atharvajshinde/Project-A.R.C./web/assets/branding/01_aerospace_frame.png

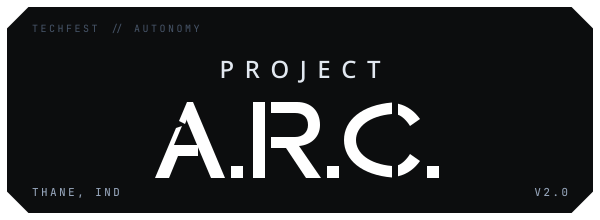
web/assets/branding/01_aerospace_frame.png
