atharvajshinde/Project-A.R.C./web/assets/branding/03_circular_seal.png

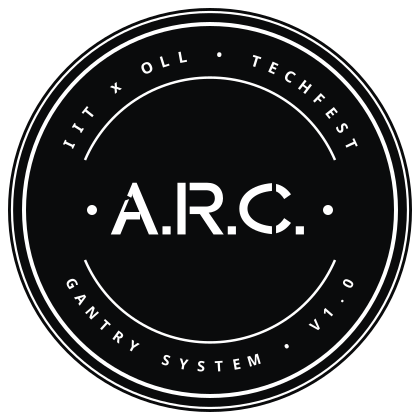
web/assets/branding/03_circular_seal.png
