atharvajshinde/Project-A.R.C./web/assets/branding/03_circular_seal_minimal.png

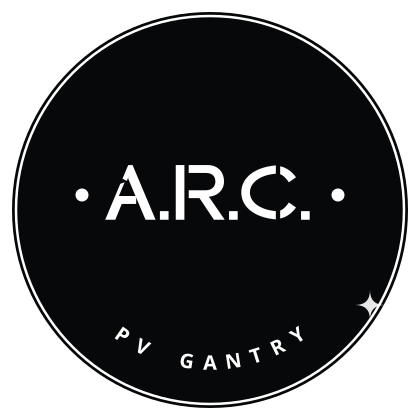
web/assets/branding/03_circular_seal_minimal.png
