atharvajshinde/Project-A.R.C./web/assets/branding/arc_sticker_sheet.png

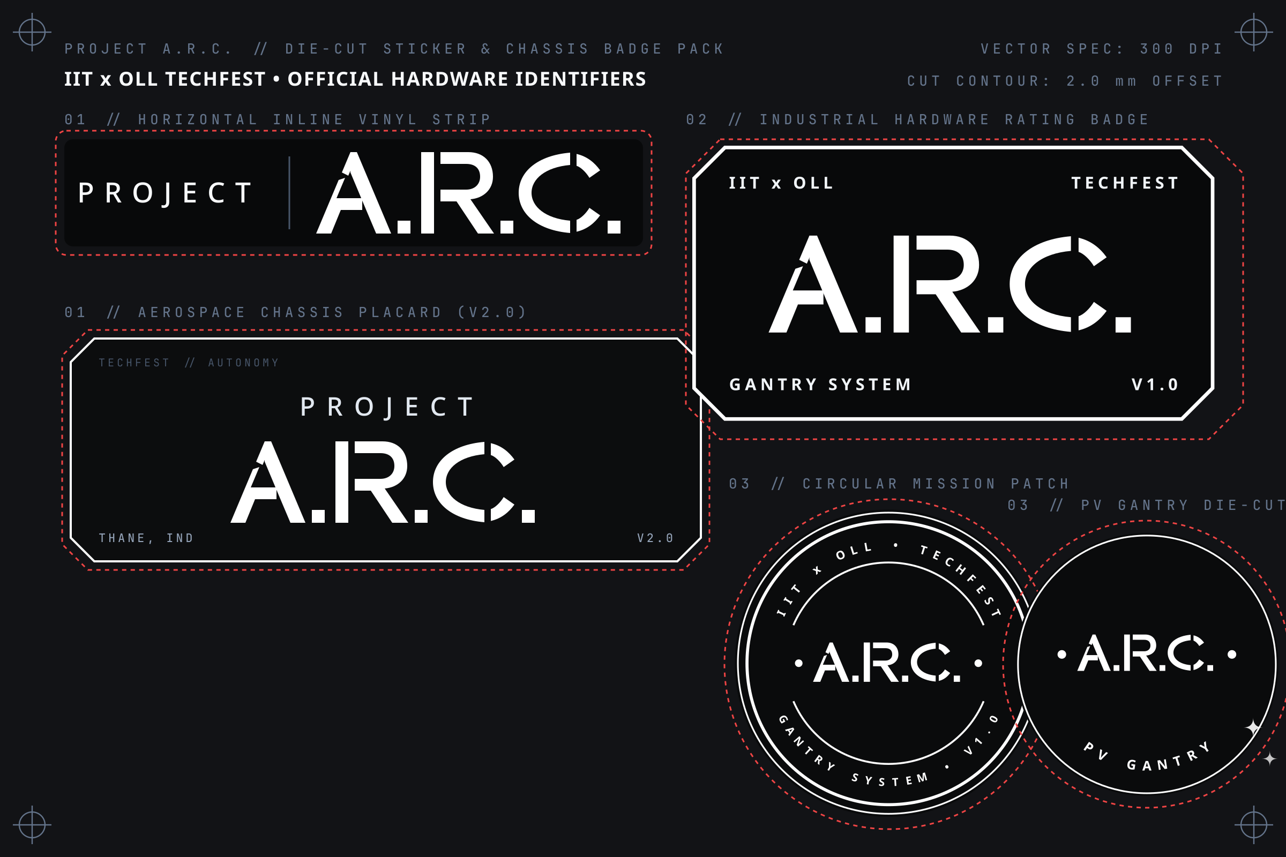
web/assets/branding/arc_sticker_sheet.png
