atharvajshinde/Project-A.R.C./cad/exports/step/arc_full_assembly.step

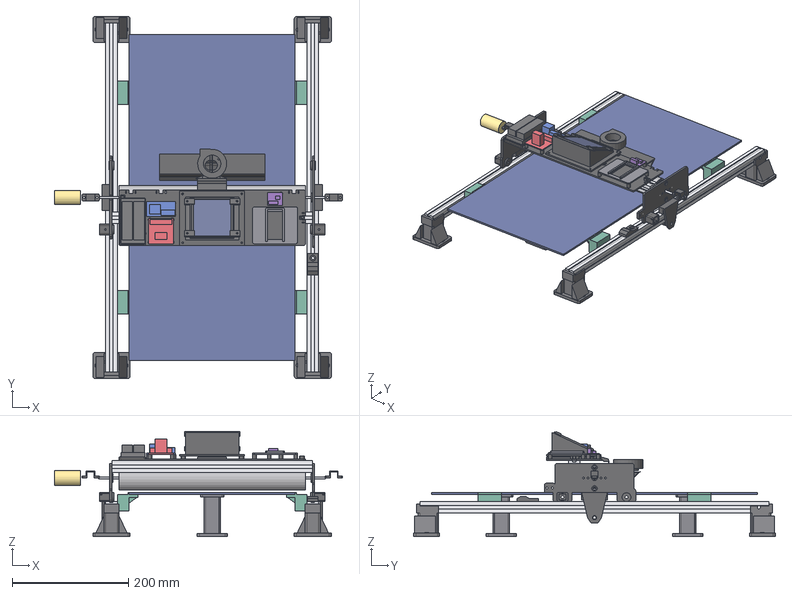
[picture p9: CAD file, 2026-10-25]
cad/exports/step/arc_full_assembly.step
495.0 x 622.0 x 180.4 mm
roller_conduit
roller_axle
roller_plug_left
roller_plug_right
endplate_left
endplate_right
motor_clamp_left
motor_clamp_right
cowl_right
chassis_tray
blower_cowl_mount
solar_wedge
pv_clip_3 x 4
limit_dog
cots_crossbeam_2020
cots_guide_rail_left
cots_vwheel_left_0
cots_vwheel_left_1
cots_vwheel_left_2
cots_guide_rail_right
cots_vwheel_right_0
cots_vwheel_right_1
cots_vwheel_right_2
cots_blower_5015
cots_motor_25ga370
cots_solar_panel
cots_pv_mini_panel
esp32_adapter_sled
cots_motor_driver_l298n
cots_relay_module
cots_ina219
cots_battery_2x18650
testbed_rail_riser_lf
testbed_rail_riser_lr
testbed_rail_riser_rf
testbed_rail_riser_rr
testbed_panel_bracket_lf
testbed_panel_bracket_lr
testbed_panel_bracket_rf
testbed_panel_bracket_rr
testbed_pedestal_front
testbed_pedestal_rear
