atharvajshinde/Project-A.R.C./cad/exports/step/arc_full_assembly_full.step

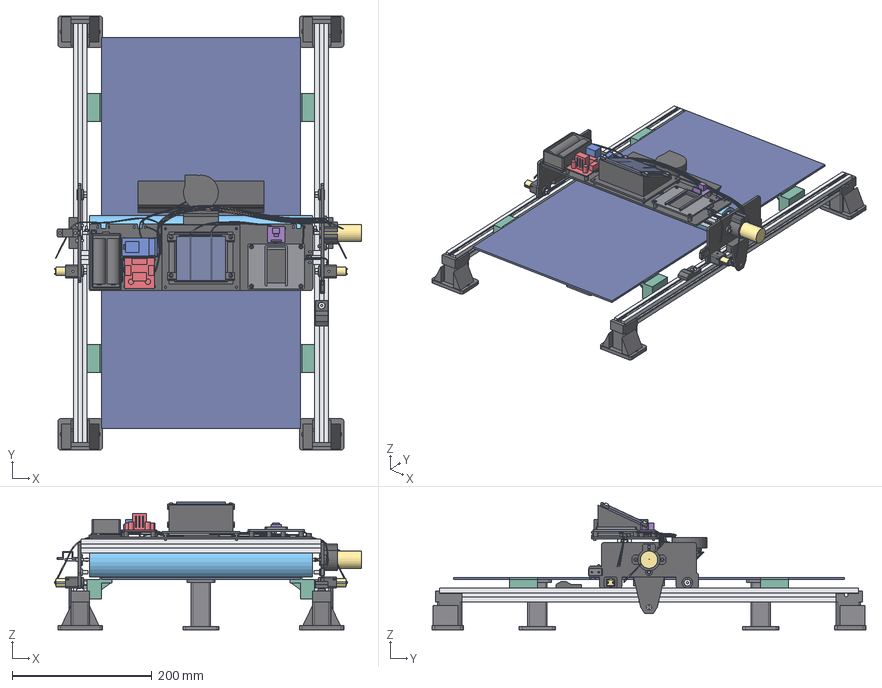
[picture p10: CAD file, 2026-10-25]
cad/exports/step/arc_full_assembly_full.step
440.2 x 622.0 x 183.0 mm
roller_conduit
roller_sleeve
roller_axle
roller_plug_left
roller_plug_right
endplate_left
endplate_right
motor_clamp_left
motor_clamp_right
cowl_right
chassis_tray
blower_cowl_mount
solar_wedge
pv_clip_3 x 4
limit_dog
cots_crossbeam_2020
cots_guide_rail_right x 2
cots_vwheel_right_2 x 6
cots_blower_5015
cots_motor_25ga370
cots_motor_n20_right x 2
coupler_n20_vwheel_left
coupler_n20_vwheel_right
cots_solar_panel
cots_pv_mini_panel
esp32_adapter_sled
cots_motor_driver_l298n
cots_relay_module
cots_ina219
cots_battery_2x18650
cots_limit_switch
hw_bearing_684zz_r x 2
hw_nut_m3_roller_plug_r x 2
hw_grub_m3_roller_plug_r x 2
hw_screw_m5_dog x 7
hw_screw_m3_wedge_base_3 x 6
hw_screw_m3_motor_clamp_r_1 x 2
hw_screw_m5_vwheel_right_2 x 6
hw_dowel_pin_cowl_1 x 2
hw_screw_m3_blower_3 x 4
hw_tnut_m5_dog x 3
hw_screw_m3_ina219_1 x 14
hw_screw_m3_pv_clip_3 x 4
wire_net_vbat_pos
wire_net_vbat_neg
wire_net_5v_sys
wire_net_gnd_sys
wire_net_blower_pwr
wire_net_blower_gnd
wire_net_motor_l_a
wire_net_motor_l_b
wire_net_motor_r_a
wire_net_motor_r_b
wire_net_motor_roller_pos
wire_net_motor_roller_neg
wire_net_limit_sig
wire_net_limit_gnd
wire_net_pv_pos
wire_net_pv_neg
wire_net_i2c_sda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
