atharvajshinde/Project-A.R.C./cad/exports/step/n20_motor_clamp.step

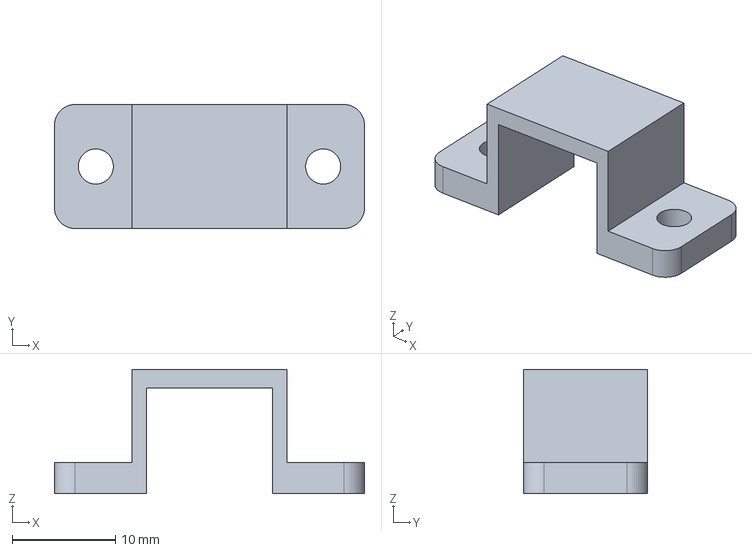
[picture p11: CAD file, 2026-10-25]
cad/exports/step/n20_motor_clamp.step
30.0 x 12.0 x 12.0 mm
