atharvajshinde/Project-A.R.C./cad/exports/stl/b123d_endplate_left.stl

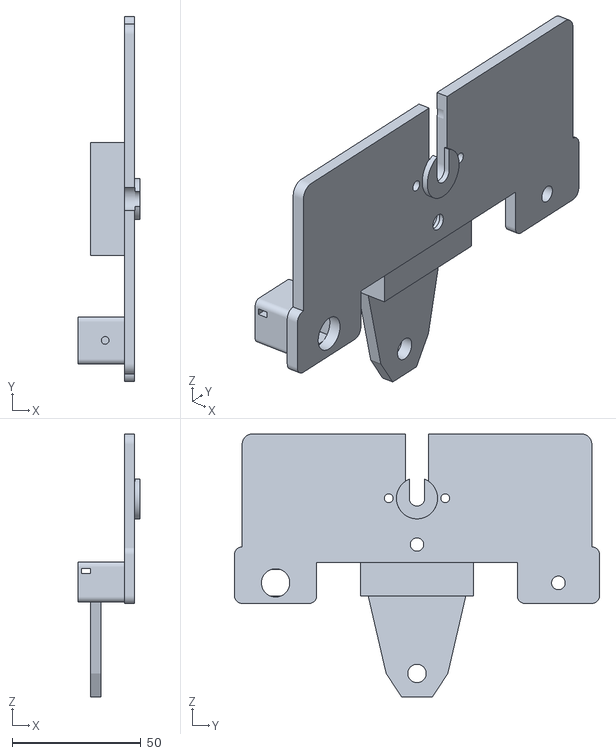
[picture p12: CAD file, 2026-10-25]
cad/exports/stl/b123d_endplate_left.stl
24.0 x 142.0 x 102.3
