atharvajshinde/Project-A.R.C./cad/stl/phase1/roller_end_plug.stl

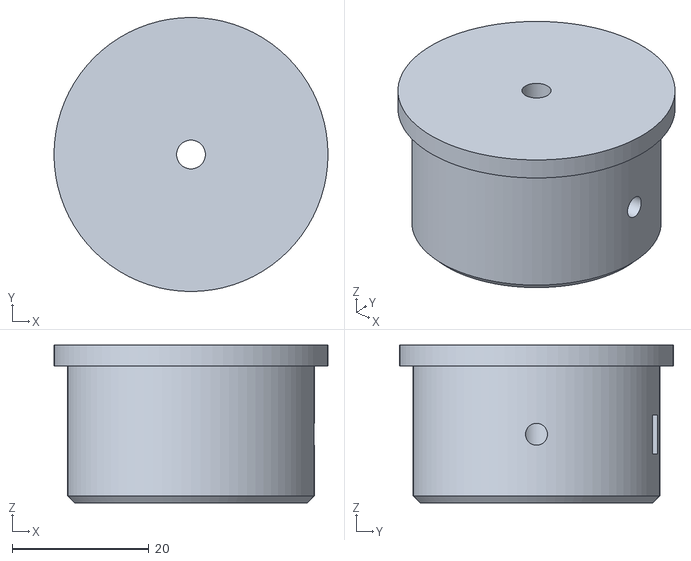
[picture p13: CAD file, 2026-10-25]
cad/stl/phase1/roller_end_plug.stl
40.0 x 40.0 x 23.0
