atharvajshinde/Project-A.R.C./cad/stl/phase2/limit_switch_trip_dog.stl

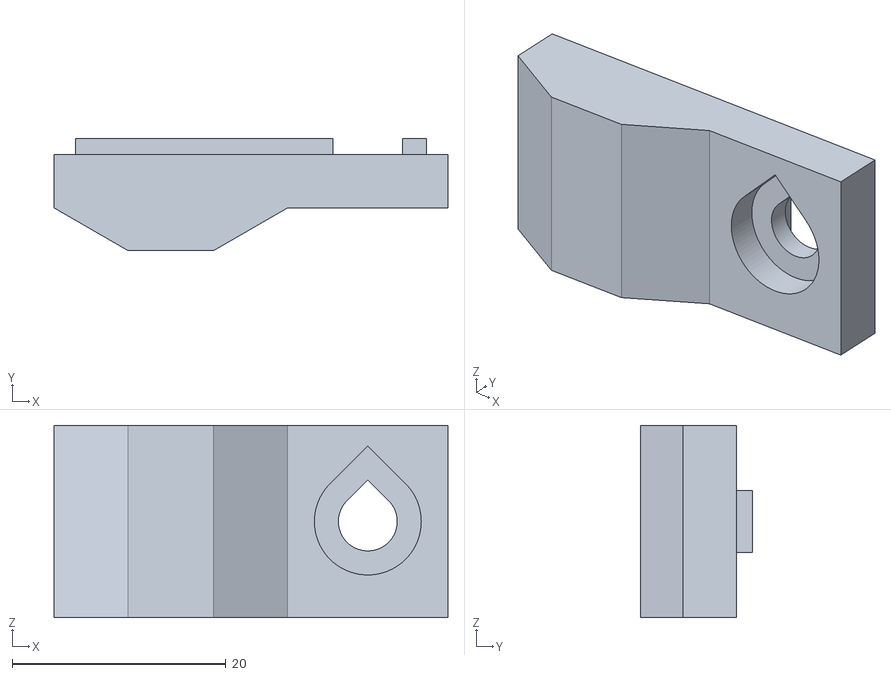
[picture p14: CAD file, 2026-10-25]
cad/stl/phase2/limit_switch_trip_dog.stl
36.9 x 10.5 x 18.0
