atharvajshinde/Project-A.R.C./cad/stl/phase3/solar_telemetry_tilt_wedge.stl

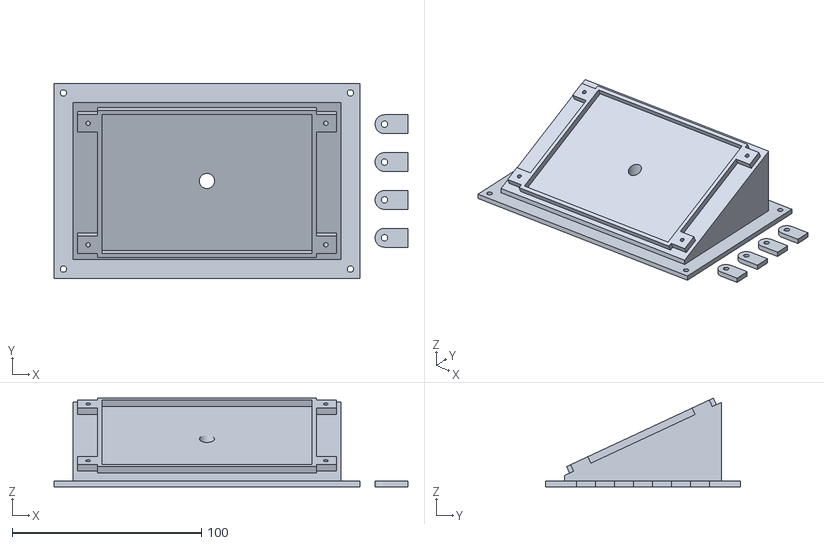
[picture p15: CAD file, 2026-10-25]
cad/stl/phase3/solar_telemetry_tilt_wedge.stl
187.0 x 103.0 x 46.9
