atharvajshinde/Project-A.R.C./cad/exports/step/blower_cowl_mount.step

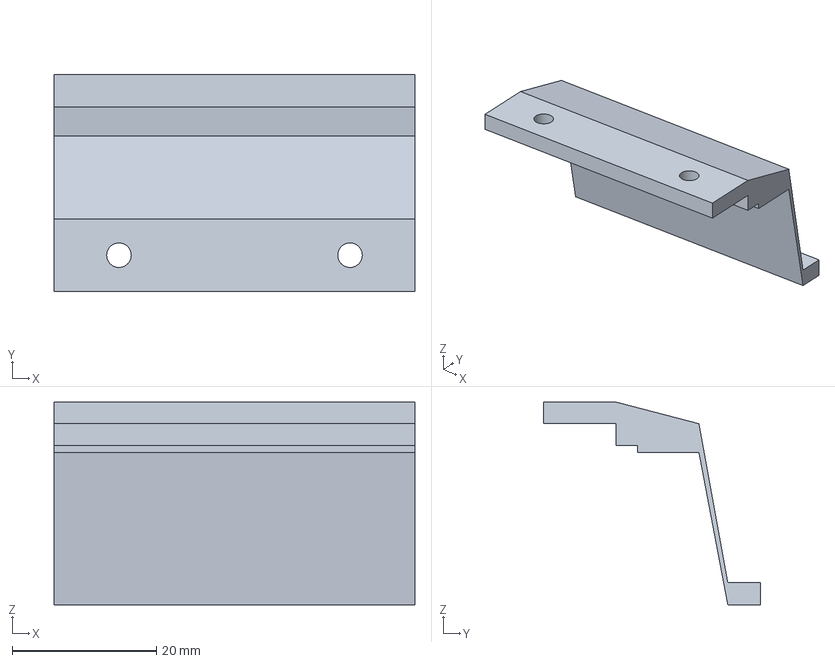
[picture p16: CAD file, 2026-10-25]
cad/exports/step/blower_cowl_mount.step
50.0 x 30.0 x 28.1 mm
