atharvajshinde/Project-A.R.C./cad/exports/stl/b123d_blower_cowl_right.stl

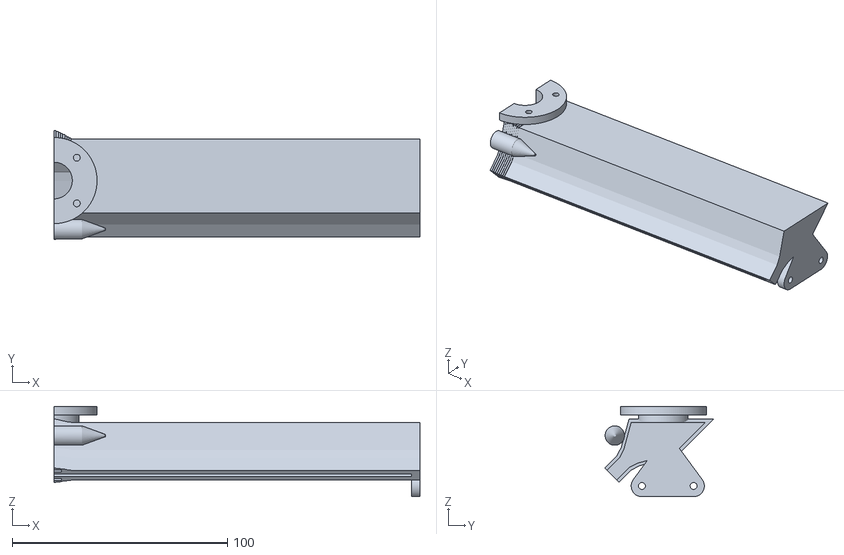
[picture p17: CAD file, 2026-10-25]
cad/exports/stl/b123d_blower_cowl_right.stl
170.0 x 50.6 x 42.0
