atharvajshinde/Project-A.R.C./cad/stl/phase1/carriage_endplate.stl

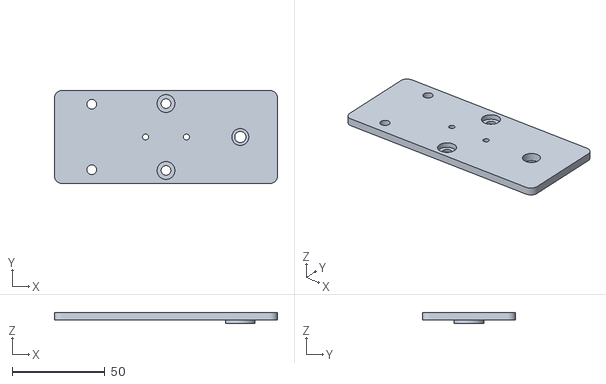
[picture p18: CAD file, 2026-10-25]
cad/stl/phase1/carriage_endplate.stl
120.0 x 50.0 x 6.00
