atharvajshinde/Project-A.R.C./cad/stl/phase2/electronics_chassis_tray.stl

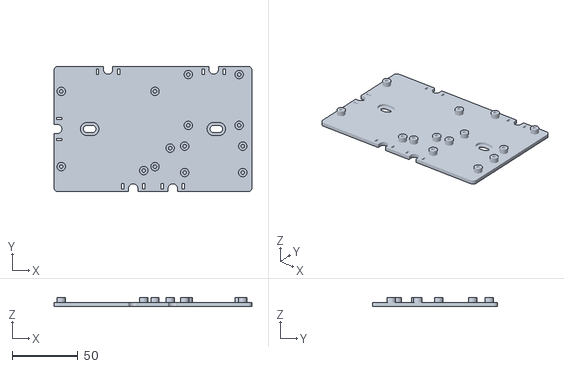
[picture p19: CAD file, 2026-10-25]
cad/stl/phase2/electronics_chassis_tray.stl
150.0 x 95.0 x 7.00
