atharvajshinde/Project-A.R.C./cad/stl/phase3/cowl_half_left.stl

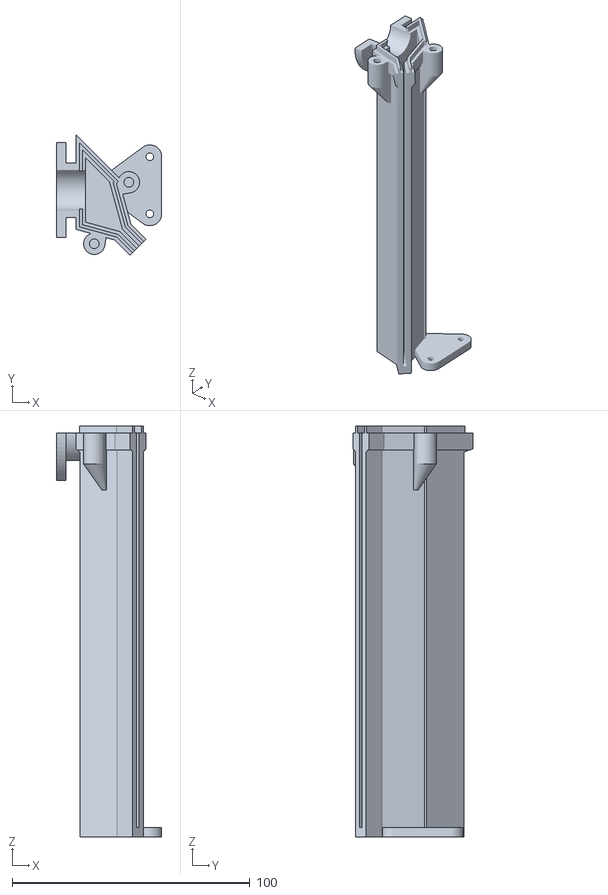
[picture p20: CAD file, 2026-10-25]
cad/stl/phase3/cowl_half_left.stl
44.4 x 50.6 x 173.0
