atharvajshinde/Project-A.R.C./cad/exports/step/motor_clamp_25ga.step

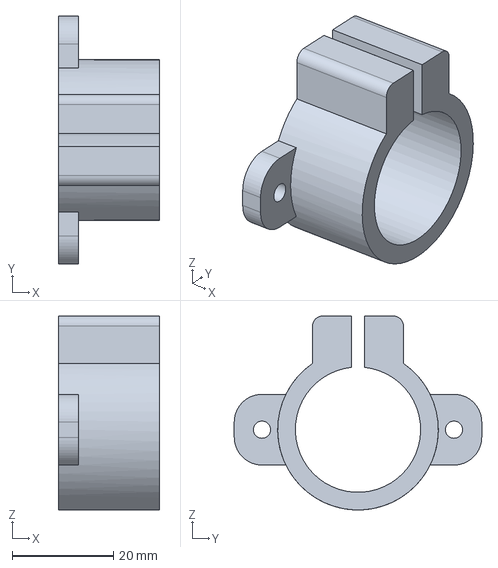
[picture p21: CAD file, 2026-10-25]
cad/exports/step/motor_clamp_25ga.step
20.0 x 49.0 x 38.4 mm
