atharvajshinde/Project-A.R.C./cad/stl/phase1/n20_motor_clamp.stl

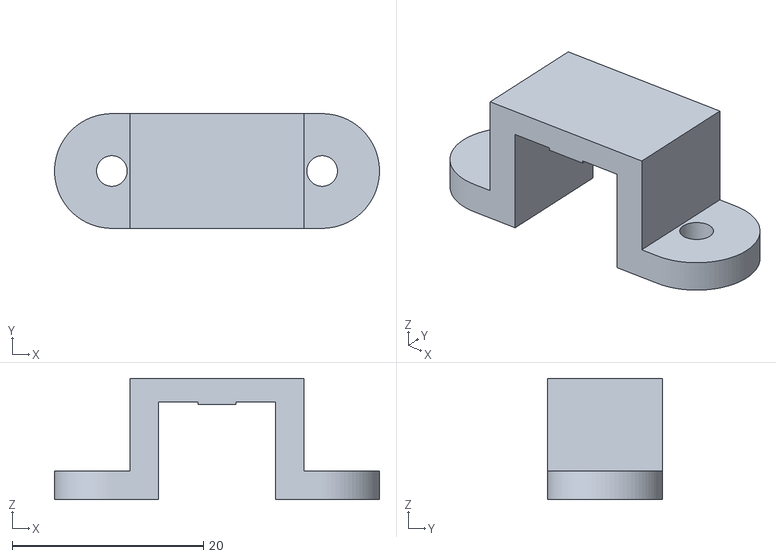
[picture p22: CAD file, 2026-10-25]
cad/stl/phase1/n20_motor_clamp.stl
34.0 x 12.0 x 12.7
