atharvajshinde/Project-A.R.C./cad/exports/step/esp32_adapter_sled.step

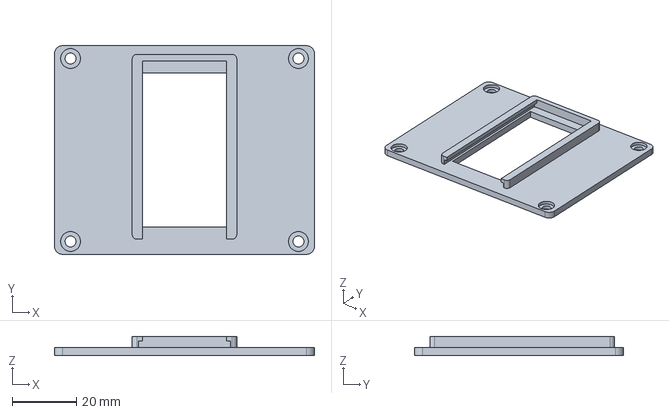
[picture p23: CAD file, 2026-10-25]
cad/exports/step/esp32_adapter_sled.step
81.0 x 65.0 x 6.00 mm
