atharvajshinde/Project-A.R.C./cad/exports/stl/b123d_roller_plug_right_25ga.stl

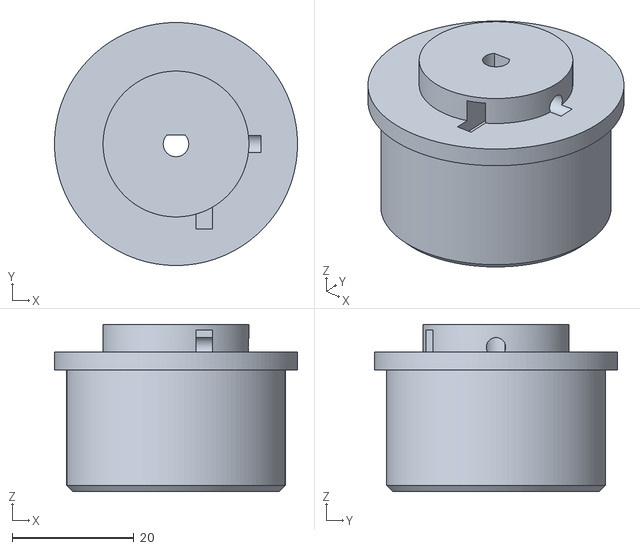
[picture p24: CAD file, 2026-10-25]
cad/exports/stl/b123d_roller_plug_right_25ga.stl
40.0 x 40.0 x 27.5
