atharvajshinde/Project-A.R.C./cad/exports/step/arc_exploded.step

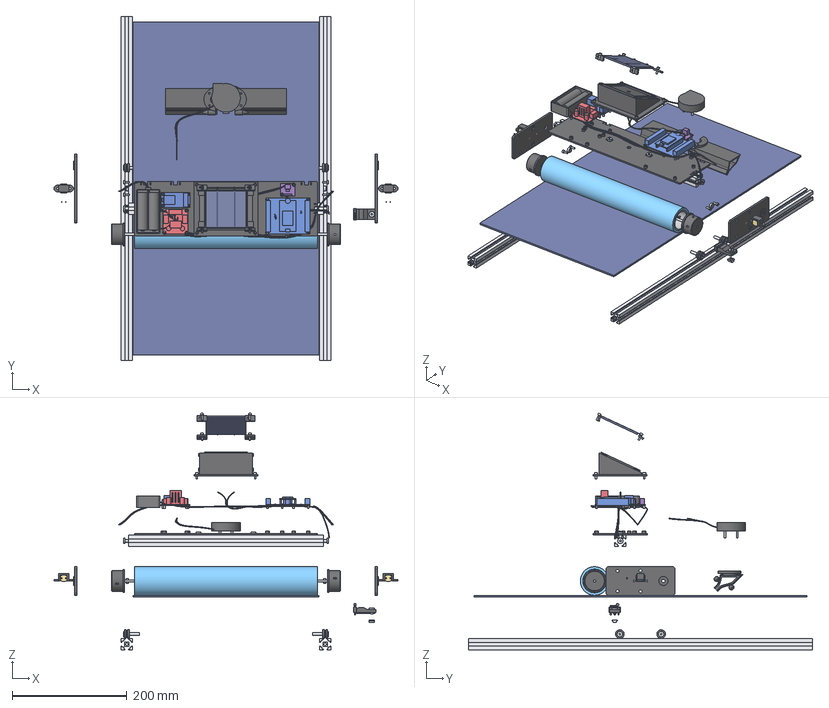
[picture p26: CAD file, 2026-10-25]
cad/exports/step/arc_exploded.step
600.0 x 600.0 x 413.1 mm
exploded_roller_conduit
exploded_roller_sleeve
exploded_roller_axle
exploded_roller_plug_left
exploded_roller_plug_right
exploded_endplate_left
exploded_endplate_right
exploded_motor_clamp_left
exploded_motor_clamp_right
exploded_cowl_right
exploded_chassis_tray
exploded_solar_wedge
exploded_pv_clip_0
exploded_pv_clip_1
exploded_pv_clip_2
exploded_pv_clip_3
exploded_limit_dog
exploded_cots_crossbeam_2020
exploded_cots_guide_rail_right x 2
exploded_cots_vwheel_right_1 x 4
exploded_cots_blower_5015
exploded_cots_motor_n20_right x 2
exploded_cots_solar_panel
exploded_cots_pv_mini_panel
exploded_cots_esp32_shield
exploded_cots_motor_driver_l298n
exploded_cots_relay_module
exploded_cots_ina219
exploded_cots_battery_2x18650
exploded_cots_limit_switch
exploded_hw_bearing_684zz_r x 2
exploded_hw_nut_m3_roller_plug_r x 2
exploded_hw_grub_m3_roller_plug_r x 2
exploded_hw_screw_m5_dog x 5
exploded_hw_screw_m3_wedge_base_3 x 8
exploded_hw_screw_m5_vwheel_right_1 x 4
exploded_hw_dowel_pin_cowl_1 x 2
exploded_hw_screw_m3_blower_3 x 4
exploded_hw_tnut_m5_dog x 3
exploded_hw_screw_m3_ina219_1 x 14
exploded_hw_screw_m3_pv_clip_3 x 4
exploded_wire_net_vbat_pos
exploded_wire_net_vbat_neg
exploded_wire_net_5v_sys
exploded_wire_net_gnd_sys
exploded_wire_net_blower_pwr
exploded_wire_net_blower_gnd
exploded_wire_net_motor_l_a
exploded_wire_net_motor_l_b
exploded_wire_net_motor_r_a
exploded_wire_net_motor_r_b
exploded_wire_net_limit_sig
exploded_wire_net_limit_gnd
exploded_wire_net_pv_pos
exploded_wire_net_pv_neg
exploded_wire_net_i2c_sda
exploded_wire_net_i2c_scl
