atharvajshinde/Project-A.R.C./cad/exports/step/roller_conduit.step

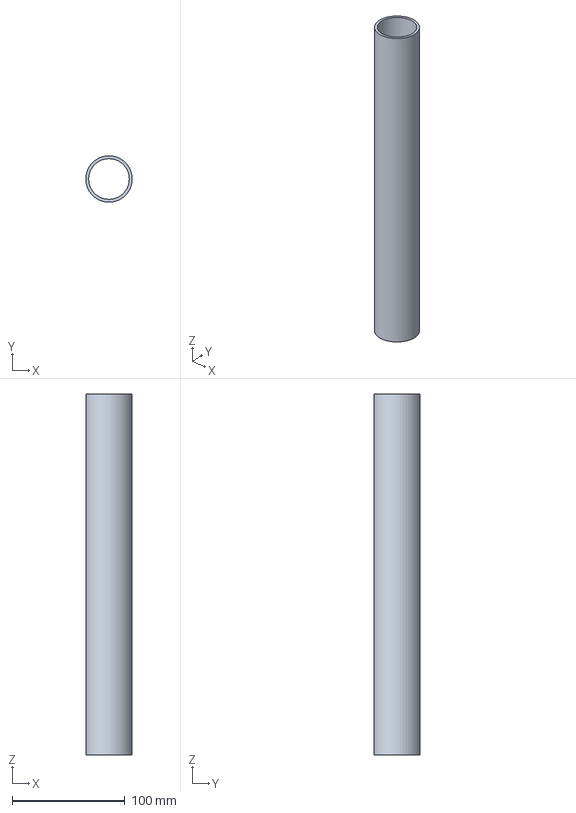
[picture p27: CAD file, 2026-10-25]
cad/exports/step/roller_conduit.step
41.2 x 41.2 x 320.0 mm
