atharvajshinde/Project-A.R.C./cad/exports/step/testbed_rail_panel_bracket.step

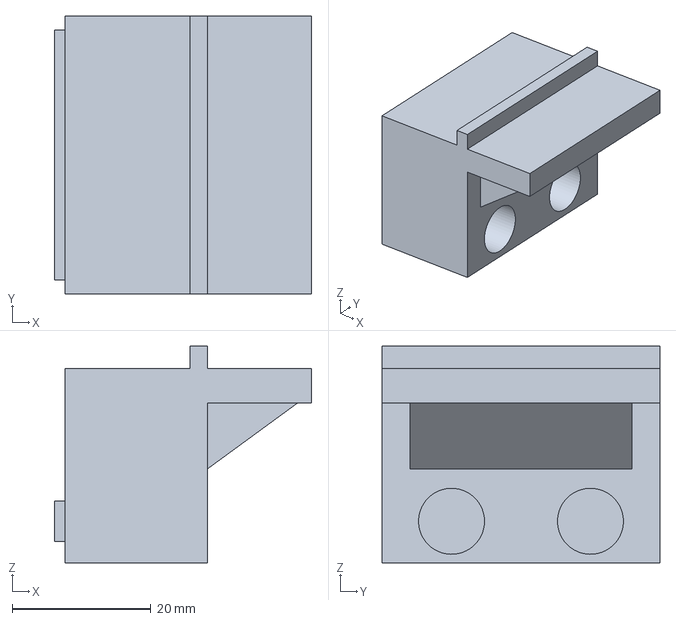
[picture p28: CAD file, 2026-10-25]
cad/exports/step/testbed_rail_panel_bracket.step
37.0 x 40.0 x 31.2 mm
