atharvajshinde/Project-A.R.C./cad/exports/stl/b123d_testbed_rail_riser_foot.stl

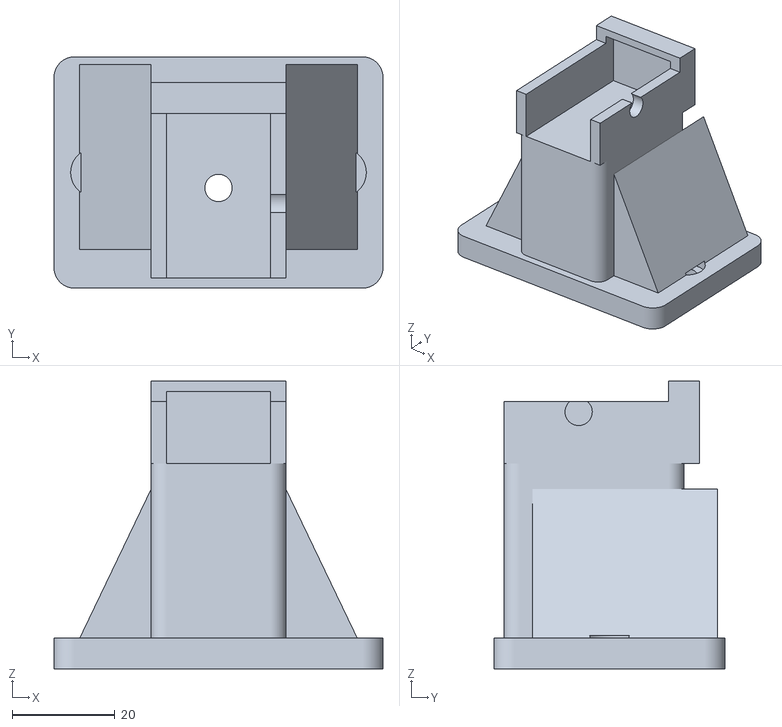
[picture p29: CAD file, 2026-10-25]
cad/exports/stl/b123d_testbed_rail_riser_foot.stl
64.0 x 45.0 x 56.0
