atharvajshinde/Project-A.R.C./cad/exports/step/pv_clamp_clip.step

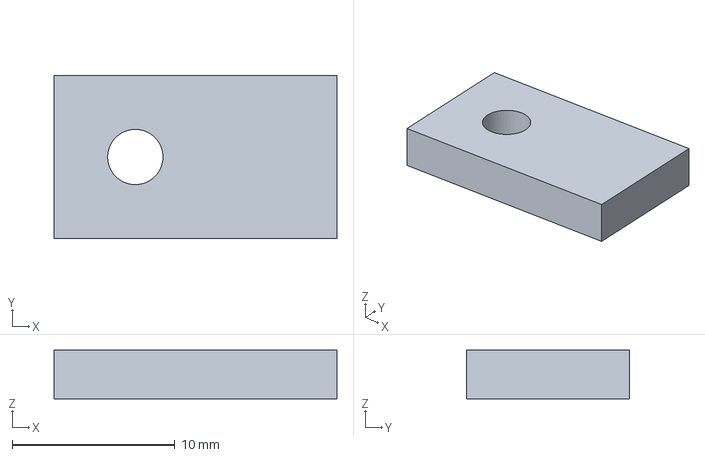
[picture p30: CAD file, 2026-10-25]
cad/exports/step/pv_clamp_clip.step
17.4 x 10.0 x 3.00 mm
