atharvajshinde/Project-A.R.C./cad/exports/stl/b123d_limit_switch_dog.stl

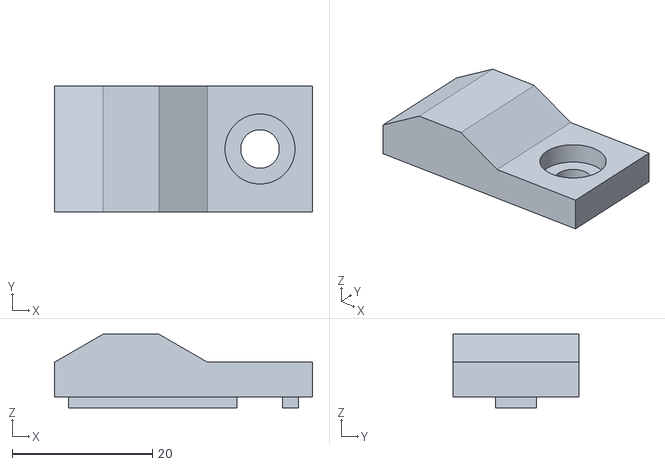
[picture p31: CAD file, 2026-10-25]
cad/exports/stl/b123d_limit_switch_dog.stl
36.9 x 18.0 x 10.5
