atharvajshinde/Project-A.R.C./cad/exports/stl/b123d_endplate_right.stl

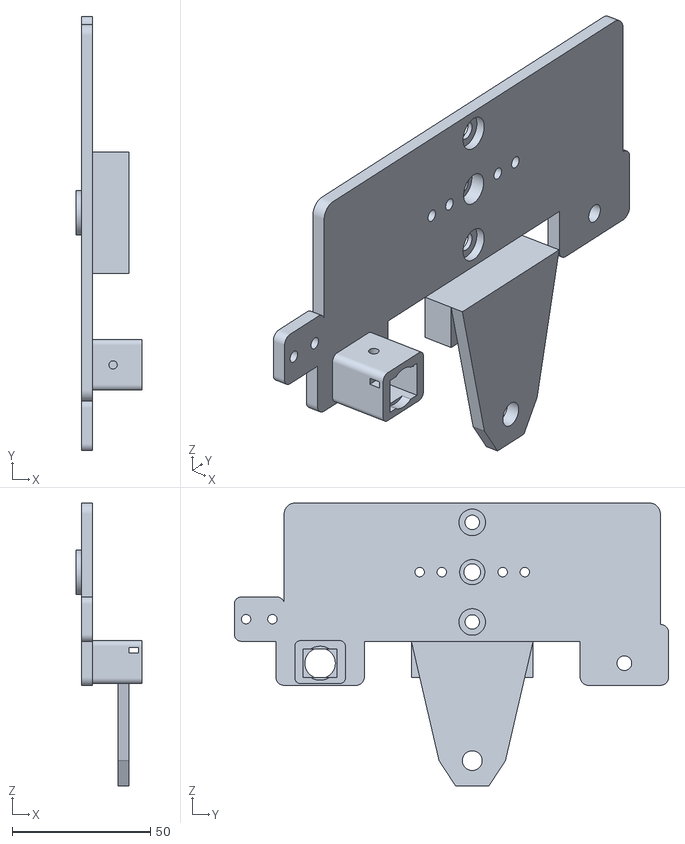
[picture p32: CAD file, 2026-10-25]
cad/exports/stl/b123d_endplate_right.stl
24.0 x 157.0 x 102.3
