atharvajshinde/Project-A.R.C./cad/exports/step/roller_axle.step

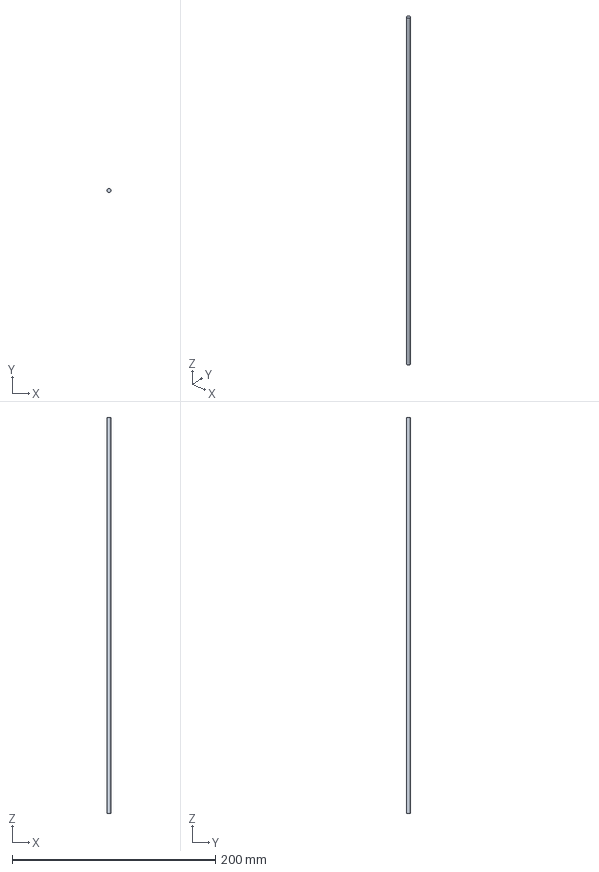
[picture p33: CAD file, 2026-10-25]
cad/exports/step/roller_axle.step
4.00 x 4.00 x 390.0 mm
