atharvajshinde/Project-A.R.C./cad/exports/stl/b123d_solar_tilt_wedge.stl

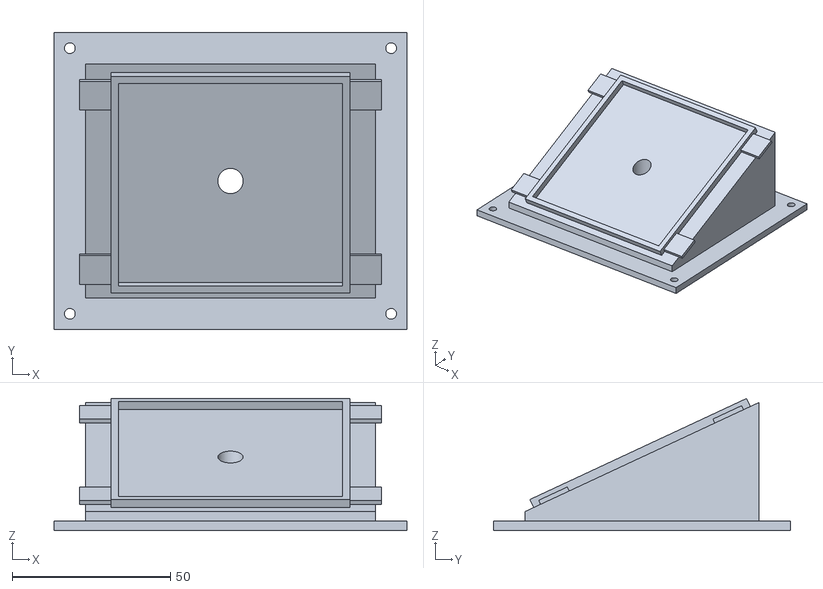
[picture p34: CAD file, 2026-10-25]
cad/exports/stl/b123d_solar_tilt_wedge.stl
111.6 x 94.0 x 41.8
