atharvajshinde/Project-A.R.C./cad/exports/step/chassis_tray.step

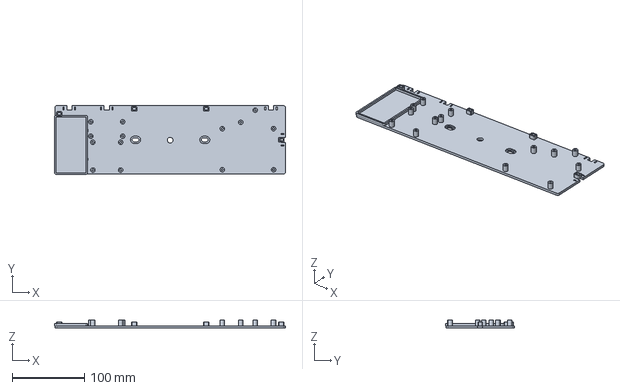
[picture p35: CAD file, 2026-10-25]
cad/exports/step/chassis_tray.step
320.5 x 95.5 x 11.0 mm
