atharvajshinde/Project-A.R.C./cad/exports/stl/b123d_coupler_n20_vwheel.stl

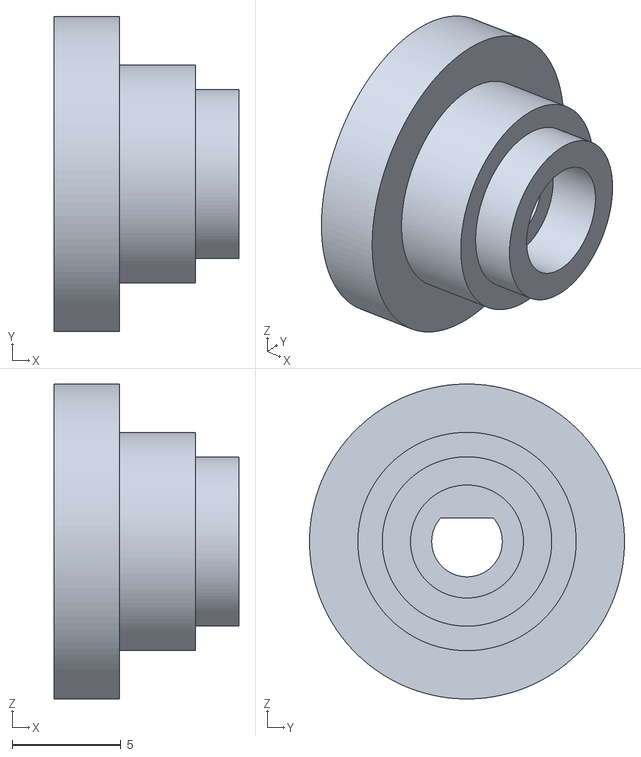
[picture p36: CAD file, 2026-10-25]
cad/exports/stl/b123d_coupler_n20_vwheel.stl
8.50 x 14.5 x 14.5
