atharvajshinde/Project-A.R.C./cad/exports/stl/b123d_testbed_panel_pedestal.stl

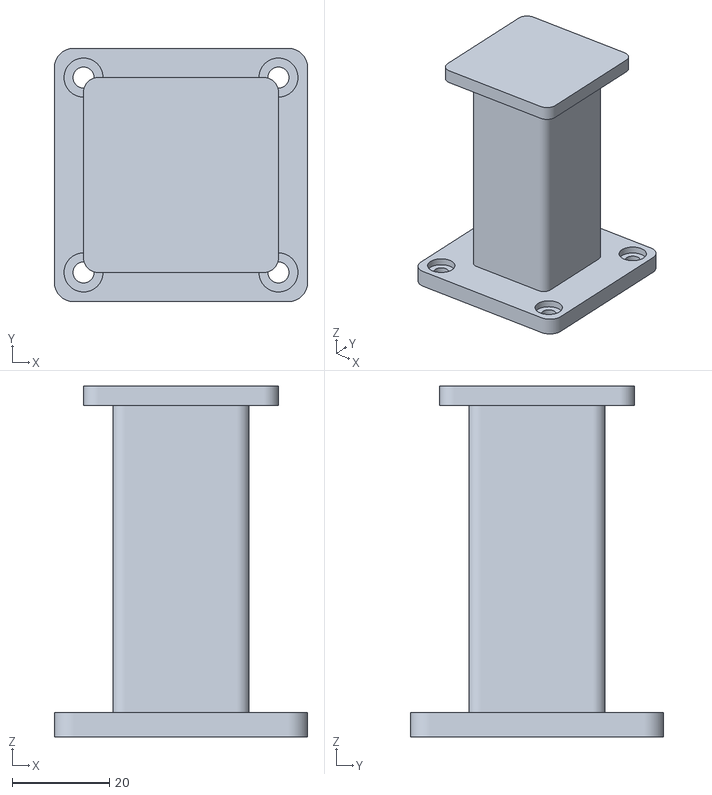
[picture p37: CAD file, 2026-10-25]
cad/exports/stl/b123d_testbed_panel_pedestal.stl
52.0 x 52.0 x 72.0
