atharvajshinde/Project-A.R.C./cad/exports/stl/b123d_carriage_endplate.stl

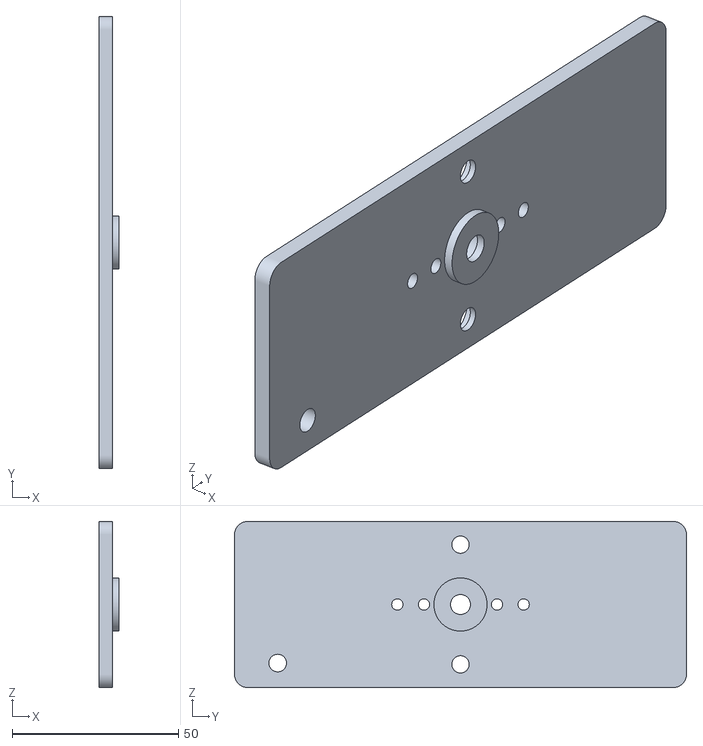
[picture p38: CAD file, 2026-10-25]
cad/exports/stl/b123d_carriage_endplate.stl
6.00 x 136.0 x 50.0
