atharvajshinde/Project-A.R.C./(list of files, cad)

Other CAD files:
cad/exports/stl/b123d_n20_motor_clamp.stl
cad/stl/phase3/cowl_half_right.stl
cad/stl/phase1/roller_plug.stl
cad/exports/step/roller_end_plug.step
cad/exports/stl/b123d_roller_end_plug.stl
cad/exports/stl/b123d_esp32_adapter_sled.stl
cad/exports/stl/b123d_motor_clamp_right_25ga.stl
cad/exports/step/blower_cowl_right.step
cad/exports/stl/b123d_chassis_tray.stl
cad/exports/step/endplate_left.step
cad/exports/stl/b123d_pv_clamp_clip.stl
cad/exports/step/blower_cowl_left.step
cad/exports/stl/b123d_testbed_rail_panel_bracket.stl
cad/exports/step/endplate_right.step
cad/exports/step/coupler_n20_vwheel.step
cad/exports/step/testbed_panel_pedestal.step
cad/exports/step/solar_tilt_wedge.step
cad/exports/step/testbed_rail_riser_foot.step
cad/exports/step/limit_switch_dog.step
cad/exports/step/carriage_endplate.step
cad/exports/stl/blower_cowl_left.stl
cad/exports/stl/blower_cowl_mount.stl
cad/exports/stl/blower_cowl_right.stl
cad/exports/stl/chassis_tray.stl
cad/exports/stl/coupler_n20_vwheel.stl
cad/exports/stl/endplate_left.stl
cad/exports/stl/endplate_right.stl
cad/exports/stl/esp32_adapter_sled.stl
cad/exports/stl/motor_clamp_25ga.stl
cad/exports/stl/n20_motor_clamp.stl
cad/exports/stl/pv_clamp_clip.stl
cad/exports/stl/roller_axle.stl
cad/exports/stl/roller_conduit.stl
cad/exports/stl/roller_end_plug.stl
cad/exports/stl/solar_tilt_wedge.stl
cad/exports/stl/testbed_rail_panel_bracket.stl
cad/exports/stl/testbed_rail_riser_foot.stl
