atharvajshinde/Project-A.R.C./cad/src/coupler_n20_vwheel.py

"""
PROJECT A.R.C. – Printed Drive Hub / Shaft Coupler: N20 to Mini V-Wheel
========================================================================
Re-exports from src.parts.couplers for backward compatibility.
"""

from __future__ import annotations
from src.parts.couplers import build_coupler_n20_vwheel

__all__ = ["build_coupler_n20_vwheel"]
