atharvajshinde/Project-A.R.C./cad/src/esp32_adapter_sled.py

"""
PROJECT A.R.C. – ESP32 Adapter Sled (src/esp32_adapter_sled.py)
==============================================================
Re-exports the 3D-printable ESP32 Adapter Sled from src.parts.sled.
"""

from __future__ import annotations
from src.parts.sled import (
    build_esp32_adapter_sled,
    make_esp32_adapter_sled,
    build_sled,
)

__all__ = [
    "build_esp32_adapter_sled",
    "make_esp32_adapter_sled",
    "build_sled",
]
