atharvajshinde/Project-A.R.C./(commit log)

2026-10-25 Initial commit: Project A.R.C. Autonomous PV Cleaning Robot
    [arc_exploded.step, arc_full_assembly.step, arc_full_assembly_full.step, b123d_blower_cowl_left.stl, b123d_blower_cowl_right.stl, b123d_carriage_endplate.stl, b123d_chassis_tray.stl, b123d_coupler_n20_vwheel.stl]
2026-10-25 docs: upgrade topology and state machine flowcharts to native Mermaid diagrams
2026-10-25 docs: add photorealistic CAD hardware render to README hero banner
