atharvajshinde/Project-A.R.C./(notices)

Notices in the files:
README.md:
License: MIT
